arcadien/simpleRgbLamp/kicad/LedLamp.kicad_sch

## KiCad design kicad/LedLamp.kicad_sch (2026-11-07)

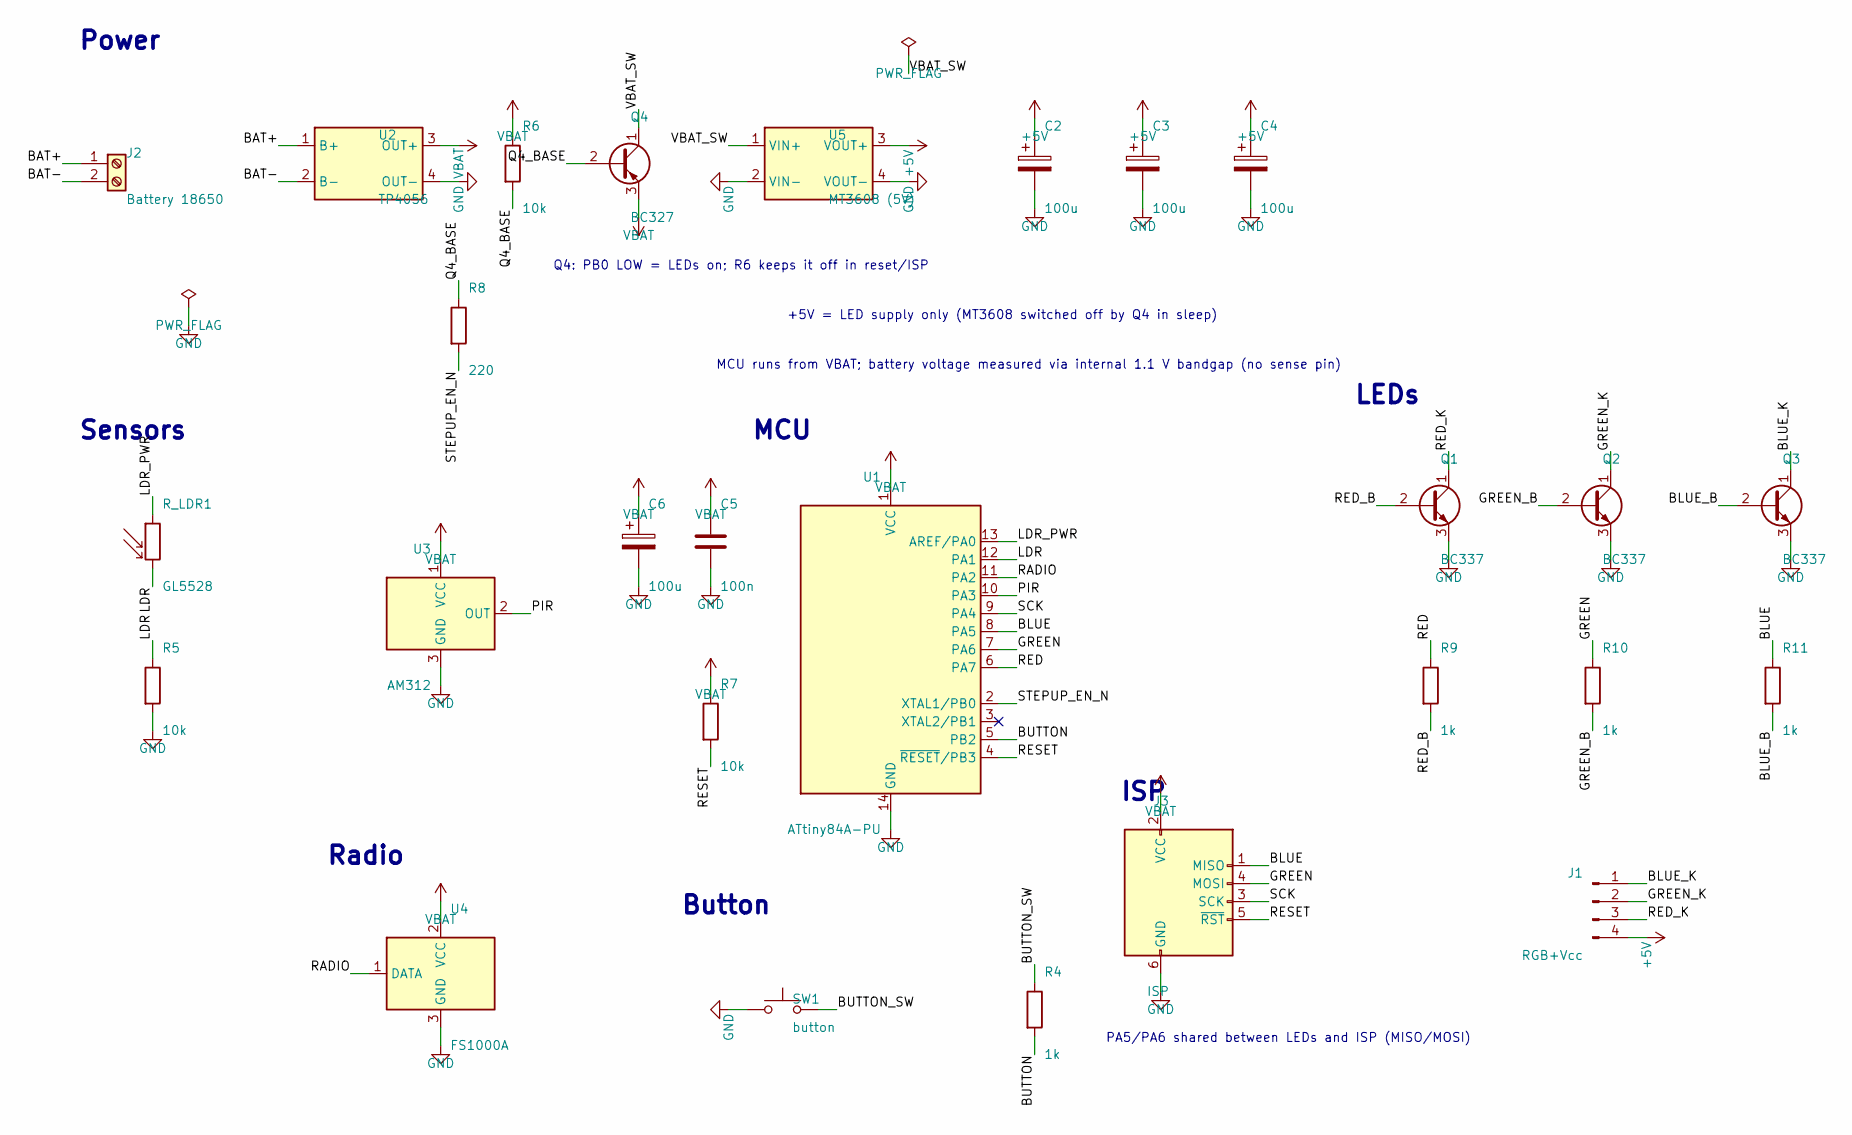
[picture p1: schematic LedLamp.kicad_sch]

Parts:
C2, C3, C4, C6: 100u; CP_Radial_D8.0mm_P5.00mm
C5: 100n; C_Disc_D5.0mm_W2.5mm_P5.00mm
J1: RGB+Vcc; FanPinHeader_1x04_P2.54mm_Vertical
J2: Battery 18650; TerminalBlock_Phoenix_MKDS-1,5-2-5.08_1x02_P5.08mm_Horizont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
J3: ISP; PinHeader_2x03_P2.54mm_Vertical
Q1, Q2, Q3: BC337; TO-92_Inline
Q4: BC327; TO-92_Inline
R4, R9, R10, R11: 1k; R_Axial_DIN0207_L6.3mm_D2.5mm_P10.16mm_Horizontal
R5, R6, R7: 10k; R_Axial_DIN0207_L6.3mm_D2.5mm_P10.16mm_Horizontal
R8: 220; R_Axial_DIN0207_L6.3mm_D2.5mm_P10.16mm_Horizontal
R_LDR1: GL5528; R_LDR_5.1x4.3mm_P3.4mm_Vertical
SW1: button; SW_PUSH_6mm_H5mm
U1: ATtiny84A-PU; DIP-14_W7.62mm
U2: TP4056
U3: AM312
U4: FS1000A
U5: MT3608 (5V)

Connections:
+5V: C2.1, C3.1, C4.1, J1.4, U5.3 (VOUT+)
BAT+: J2.1, U2.1 (B+)
BAT-: J2.2, U2.2 (B-)
BLUE: J3.1 (MISO), R11.1, U1.8 (PA5)
BLUE_B: Q3.2 (B), R11.2
BLUE_K: J1.1, Q3.1 (C)
BUTTON: R4.2, U1.5 (PB2)
BUTTON_SW: R4.1, SW1.2
GND: C2.2, C3.2, C4.2, C5.2, C6.2, J3.6 (GND), Q1.3 (E), Q2.3 (E), Q3.3 (E), R5.2, SW1.1, U1.14 (GND), U2.4 (OUT-), U3.3 (GND), U4.3 (GND), U5.2 (VIN-), U5.4 (VOUT-)
GREEN: J3.4 (MOSI), R10.1, U1.7 (PA6)
GREEN_B: Q2.2 (B), R10.2
GREEN_K: J1.2, Q2.1 (C)
LDR: R5.1, R_LDR1.2, U1.12 (PA1)
LDR_PWR: R_LDR1.1, U1.13 (AREF/PA0)
PIR: U1.10 (PA3), U3.2 (OUT)
Q4_BASE: Q4.2 (B), R6.2, R8.1
RADIO: U1.11 (PA2), U4.1 (DATA)
RED: R9.1, U1.6 (PA7)
RED_B: Q1.2 (B), R9.2
RED_K: J1.3, Q1.1 (C)
RESET: J3.5 (~RST), R7.2, U1.4 (~RESET/PB3)
SCK: J3.3 (SCK), U1.9 (PA4)
STEPUP_EN_N: R8.2, U1.2 (XTAL1/PB0)
VBAT: C5.1, C6.1, J3.2 (VCC), Q4.3 (E), R6.1, R7.1, U1.1 (VCC), U2.3 (OUT+), U3.1 (VCC), U4.2 (VCC)
VBAT_SW: Q4.1 (C), U5.1 (VIN+)

Notes on the sheet:
MCU
+5V = LED supply only (MT3608 switched off by Q4 in sleep)
MCU runs from VBAT; battery voltage measured via internal 1.1 V bandgap (no sense pin)
ISP
PA5/PA6 shared between LEDs and ISP (MISO/MOSI)
LEDs
Power
Button
Radio
Q4: PB0 LOW = LEDs on; R6 keeps it off in reset/ISP
Sensors
