arcadien/simpleRgbLamp/(commit log)

2022-10-09 Rework folders
    [LedLamp.sch]
2022-10-09 Removed pull-down for mosfet gates
    [LedLamp.sch]
2022-10-09 Enhancements and lower power
    * Use RGB value /6 to lower used power
    * Put RGB setup in PROGMEM to save RAM
    * Add new 'pink' RGB setup
    * Use Lowpower lib to put MCU to sleep when not changing RBG setup
2022-10-09 Fix interrupt management
    * Power draw is around 11mA when led is on with 5.5v input. When deep
    sleeping (led off), it falls to some µA.
    [sketch.ino]
2022-10-09 Now use LOW level on INT0
    [LedLamp.sch]
2022-10-09 feat: Implement inactivity sleep
    * After a delay set to 6 hours, the lamp will shut down.
    When user clicks on the button, the last order color will be
    restored, and another 6 hours period starts.
    Note: In this version the inactivity counter is never reset.
    [sketch.ino]
2022-10-09 fix: deactivate watchdog before deepsleep
    [sketch.ino]
2022-10-09 New release
    * Better management of color switch button
    * Added movement sensor on pin A4:
    - Movement triggers light
    - End of movement shuts off lights
    * Button still allow to change color between 5 preview
    * Button still allow to deep sleep
    * No longer use EEPROM to store last used color. If system shuts down,
    one has to re-select a color. Initial value is red.
    * Added info message via Serial in debug mode
    [sketch.ino]
2022-10-09 feat: Update Kikad project to recent Kikad version
    [LedLamp.kicad_sch]
2022-10-13 refactor: Explicit macro for debug serial prints
2022-10-13 feat: Add battery monitoring
2023-11-16 feat: Rework Arduino prototype
    [sketch.ino]
2023-11-18 Fix: raise the luminosity threshold
    [sketch.ino]
2023-11-18 Fix: faster notification for 'too much ambiant light'
    [sketch.ino]
2023-11-18 Fix: account button switched event has been consumed
    [sketch.ino]
2023-11-19 Specification update
    * Fix constant names and value
    * Adjust 'on' time when a movement is detected (rely on sensor)
2023-11-19 Update Ω value of LDR resistor
2023-12-05 feat: send battery voltage by 433Mhz each time it awakes from deep sleep
2026-11-07 fix: rework KiCad schematic to match the built lamp
    - Arduino Pro Mini symbol replaces the unpowered bare ATmega328P
    - button moved from PD0 to D2/INT0 (firmware BUTTON=2)
    - add TP4056 charger, MT3608 5V step-up, 18650 terminal (2-pin footprint)
    - add GL5528 + 10k on A0, VBAT sense on A1, HC-SR501 on A4, FS1000A on D10
    - add 100nF decoupling on +5V, R4 footprint, MOSFETs valued IRFZ44N
    - project symbol library LedLamp.kicad_sym, KiCad 10 format
2026-11-07 docs: align README hardware section with schematic and firmware
2026-11-07 feat: replace Pro Mini by an ATtiny84A powered from the battery
    - ATtiny84A (DIP-14, internal 8 MHz) on VBAT, 2x3 ISP header, RESET pull-up
    - MT3608 step-up feeds the LEDs only, input switched by AO3401A P-MOSFET (PB0)
    - AM312 PIR replaces HC-SR501, FS1000A on VBAT
    - LDR divider powered from PA0, IRLZ44N logic-level LED MOSFETs
    - 100uF + 100nF on VBAT
2026-11-07 feat: port firmware to the ATtiny84A
    - pins remapped (PWM on PA7/PA6/PA5, button PCINT10 on PB2, PIR PCINT3 on PA3)
    - step-up switched off whenever the LEDs are off
    - VCC measured via the 1.1 V bandgap, LDR powered only while measuring
    - LowPower lib replaced by avr/sleep; explicit fuses (8 MHz, BOD 2.7 V)
    - LOW_POWER_MV 3000 (8 MHz needs >= 2.7 V, protects the 18650)
    - fix: radio pin never set as output, Serial always started
2026-11-07 docs: document the ATtiny84A hardware and ISP power warning
2026-11-07 feat: switch LED step-up with a BC327 PNP instead of an SOT-23 P-MOSFET
    Through-hole for the stripboard; R8 220R base resistor (Ib 10-16 mA), R6 10k base-emitter keeps it off during reset/ISP. LED load <= 0.1 A.
2026-11-07 docs: describe BC327 step-up switch
2026-11-07 feat: drive LED colors with BC337 NPN instead of IRLZ44N
    LED current <= 0.1 A total: TO-92 NPN with 1k base resistors (R9-R11) saturates at any battery voltage, no gate threshold issue. Firmware polarity unchanged (HIGH = on).
2026-11-07 docs: LED drivers are BC337
2026-11-07 feat: explicit lamp states in the main loop
    Replace the doSleep/doDeepSleep flags and nested if/else in loop()
    with a LampState enum (LowBattery, ColorSelect, TooBright, NightMotion,
    NightIdle), a pure evaluate() picking the state by priority, and a
    switch running each state's action.
    - PIR level is read directly; its ISR only wakes the MCU, so no stale
    movement flag survives a daylight wake-up
    - no more 10 ms color flash when motion ends in the dark
    - SERIAL_OUT logs state transitions only
    - drop unused buttonPressed and dead `if (!buttonSwitched)` check
2026-11-07 fix: skip LDR reading while lit by motion
    In NightMotion the lamp light reaches the LDR and could trip
    TooBright, switching the lamp off by itself. Keep the current state
    in lampState and only read the LDR outside NightMotion; the lamp
    leaves that state on PIR low, button release or low battery.
2026-11-07 docs: fix HLR issue links and record implementation status
    Links were off by one (#1 is a PR). HLR4 duplicates HLR1. HLR5 is only
    partly met (battery sent on wake-up, not every 15 min); HLR6 and HLR7
    are not implemented.
2026-11-07 docs: HLR5 sends battery level on each wake-up
    Periodic emission would need a watchdog wake-up and its sleep current;
    sending on wake-up is what the firmware does since ded54c8.
